mike-rankin/ESP32_eZ_Display_2/Images/LCD.jpg

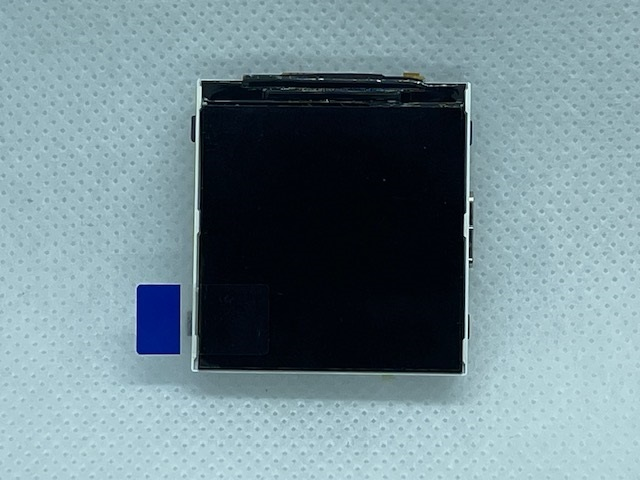
Images/LCD.jpg
