mike-rankin/ESP32_eZ_Display_2/Images/IMG_1215.jpg

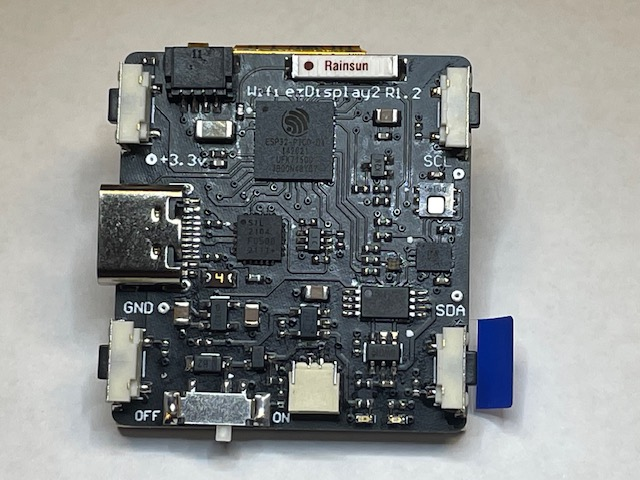
Images/IMG_1215.jpg
