mike-rankin/ESP32_eZ_Display_2/Images/display.jpg

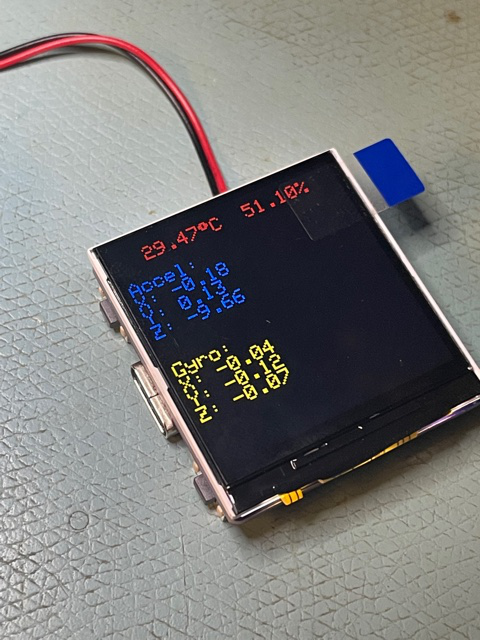
Images/display.jpg
