mike-rankin/ESP32_eZ_Display_2/PCB/BOM_Rev1.2.xlsx

Designator | Quantity | Vendor | Description | Manufacturer | Value | LCSC_Part_Number | Man_Part_Number
A1 | 1 | LCSC | Antenna Chip 2.4Gig | Rainsun | Chip Antenna | C99665 | AN9520-245
C1, C4, C6, C10, C12 | 5 | LCSC | CAP 0.1uF 0402 | CCTC | 0.1uF | C344190 | TCC0402X5R104M160AT
C2 | 1 | LCSC | CAP 1.5pF 0402 | Dafron | 1.5pF | C147344 | C1005NP0159CGTS
C3 | 1 | LCSC | CAP 1uF 16V 0402 | Walsin | 1uF | C83063 | 0402X105K160CT
C5 | 1 | LCSC | CAP 100uF 6.3V 1206 | Taiyo Yuden | 100uF | C87164 | JMK316BJ107ML-T
C7, C8, C9, C11 | 4 | LCSC | CAP 10uF 0805 | Samsung | 10uF | C307520 | CL21A106KOQNNNG
D1 | 1 | LCSC | DIODE SCHOTTKY 20V 500MA SOD123 | CJ | MBR0520 | C475717 | MBR0520
D2 | 1 | LCSC | LED Green 0402 | Lite-On | Green Led | C74338 | 16-213/GHC-YR1S1/3T
D3 | 1 | LCSC | LED RED 0402 | Lite-On | Red Led | C364556 | LTST-C281KRKT
D4 | 1 | LCSC | LED,RGB LED,SMD,RoHS | Foshan | RGB Led | C158099 | FC-B1010RGBT-HG
F1 | 1 | LCSC | PTC FUSE 500mA hold, 1A trip 0805 SMD | TLC | TLC-PSMD050 | C261942 | TLC-PSMD050
H1 | 1 | LCSC | CONN HEADER 4POS .100 R/A QWIIC | JST | QWiiC | C160404 | SM04B-SRSS-TB(LF)(SN)
J1 | 1 | LCSC | CONN RECPT USB-C | KHE | USB-C | C165948 | TYPE-C-31-M-12
J2 | 1 | LCSC | MIcro CONN 2POS 1.0MM SMT R/A | JUSHUO | Batt Con | C395299 | AFC10-S02QCC-00
Q1 | 1 | LCSC | TRANS 2NPN 44V 0.1A SC-70-6 | Changjiang | BC847S | C148112 | BC847S
Q2 | 1 | LCSC | MOSFET P-CH 20V 1.4A SC-70 | LRC | P-CH Mosfet | C172434 | LP1480WT1G
Q3 | 1 | LCSC | TRANSISTOR NPN GP 40V SC-70 | Changjiang | MMST3904 | C54879 | MMST3904
Q4 | 1 | LCSC | MOSFET 2N-CH 20V 6A TSSOP-8L | Fortune | FS8205A | C16052 | FS8205A
R1, R2, R3, R6, R7, R8, R9, R13, R14, R17 | 10 | LCSC | RES 10K 0402 | Guangdong | 10K | C258091 | RC-02W1002FT
R4, R5, R20, R21 | 4 | LCSC | RES 4.7K 0402 | Uni-Royal | 4.7K | C25900 | 0402WGF4701TCE
R10, R11 | 2 | LCSC | RES 5.1K 0402 | TyoHM | 5.1K | C325521 | RMC04025.1K1%N
R12 | 1 | LCSC | RES 22R 0402 | Uniroyal | 22R | C25092 | 0402WGF220JTCE
R15, R22, R23, R24, R25 | 5 | LCSC | RES 1K 0402 | Yageo | 1K | C106235 | RC0402FR-071KL
R16, R26, R27 | 3 | LCSC | RES 100K 0402 | Uniroyal Elec | 100K | C25741 | 0402WGF1003TCE
R18 | 1 | LCSC | RES 22K 0402 | LIZ Elec | 22K | C100310 | CR0402FF2202G
R19 | 1 | LCSC | RES 100R 0402 | Yageo | 100R | C106232 | RC0402FR-07100RL
S1, S2, S4, S5 | 4 | LCSC | Side Actuated Button R/A | HYP | Button R/A | C319377 | 1TS002G-2300-3500-CT
S3 | 1 | LCSC | SWITCH SLIDE SMD | Korean Hroparts Elec | SWITCH SLIDE | C128955 | K3-1296S-E1
U1 | 1 | LCSC | RF Transceiver ICs QFN-48_7x7x05P RoHS | Espressif | ESP32-PICO-D4 | C193707 | ESP32-PICO-D4
U2 | 1 | LCSC | IC BRIDGE USB TO UART 24QFN | Silicon Labs | CP2104N | C47742 | CP2104-F03-GMR
U3 | 1 | LCSC | IMU ACCEL/GYRO I2C/SPI 14VFLGA | ST MICRO | LSM6DS3TR | C95230 | LSM6DS3TR
U4 | 1 | LCSC | Humidity/Temperature Sensor | Texas Instruments | HDC1080DMBT | C82227 | HDC1080DMBR
U5 | 1 | LCSC | IC LDO 3.3V 0.5A SOT23-5 | Holtek | HT7833 | C164106 | HT7833
U6 | 1 | LCSC | Charger IC Lithium-Ion/Polymer SOT23-5 | Microchip | MCP73831T-2ACI | C424093 | MCP73831T-2ACI/OT
U7 | 1 | LCSC | IC LITHIUM BATT PROTECT SOT-23-6L | PUOLOP | DW01A | C351410 | DW01A
X1 | 1 | BuyDisplay | 1.54 INCH TFT GLASS COLOR | BuyDisplay | TFT_1.54" |  | ER-TFT1.54-1
