mike-rankin/ESP32_eZ_Display_2/PCB/Parts_Placement_Rev1.2.pdf

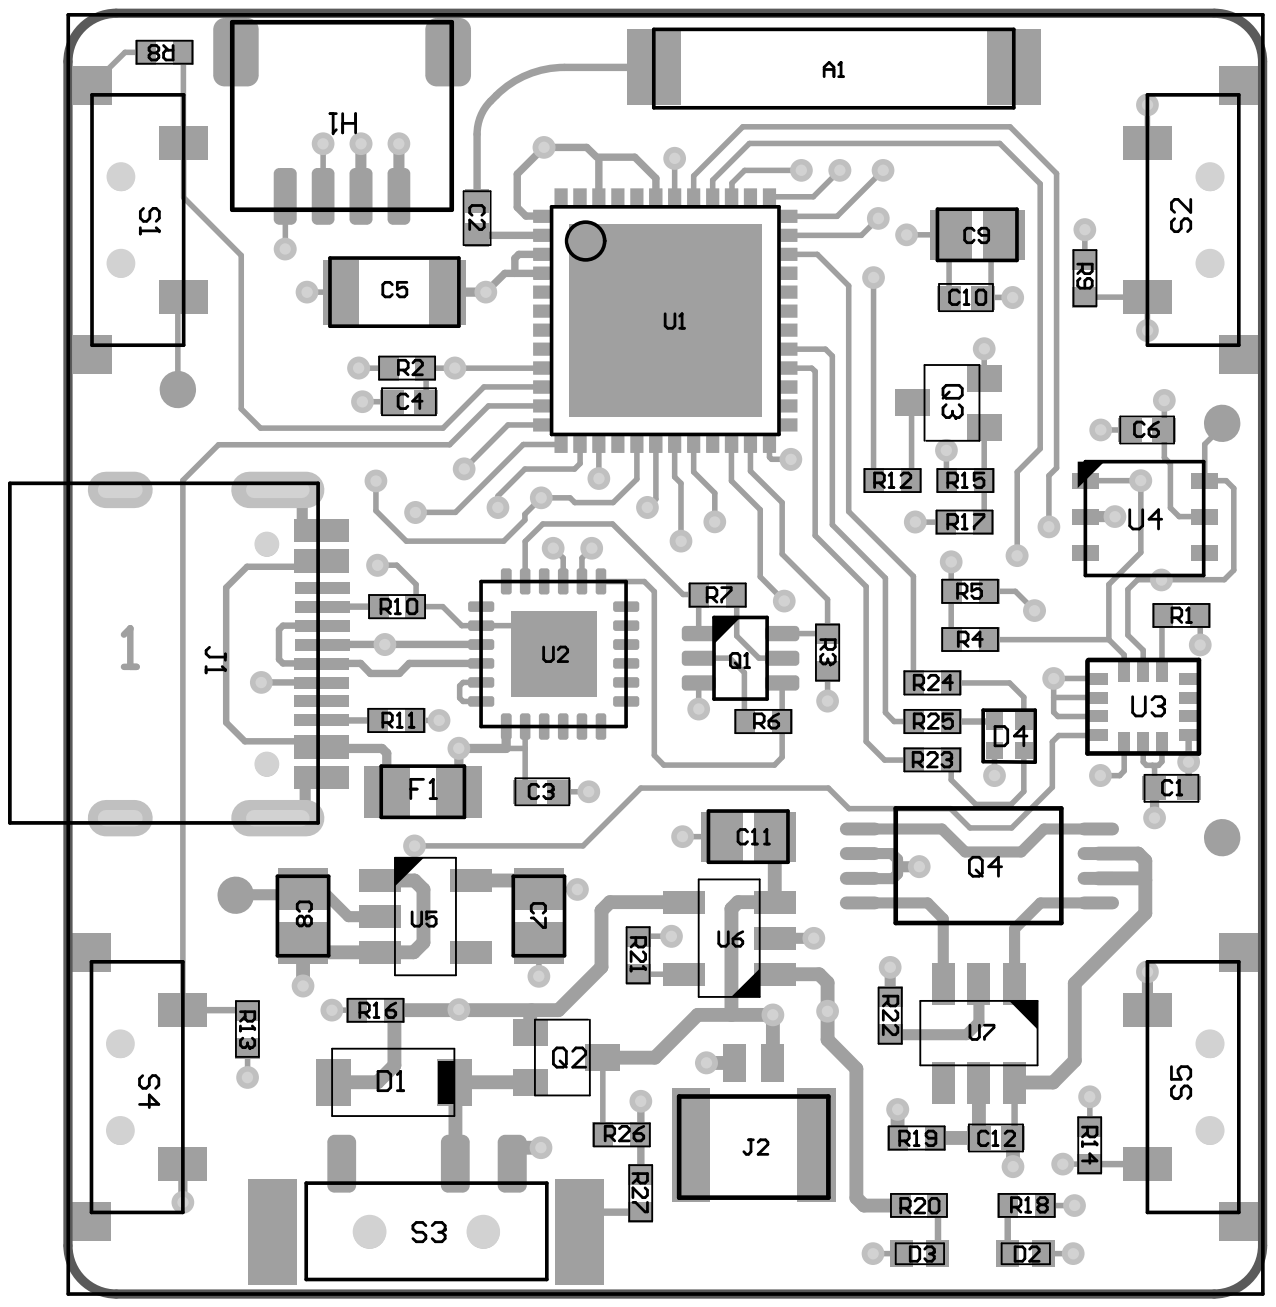
[picture p4: page 1]
