mike-rankin/ESP32_eZ_Display_2/PCB/Schematic_Rev1.2.pdf

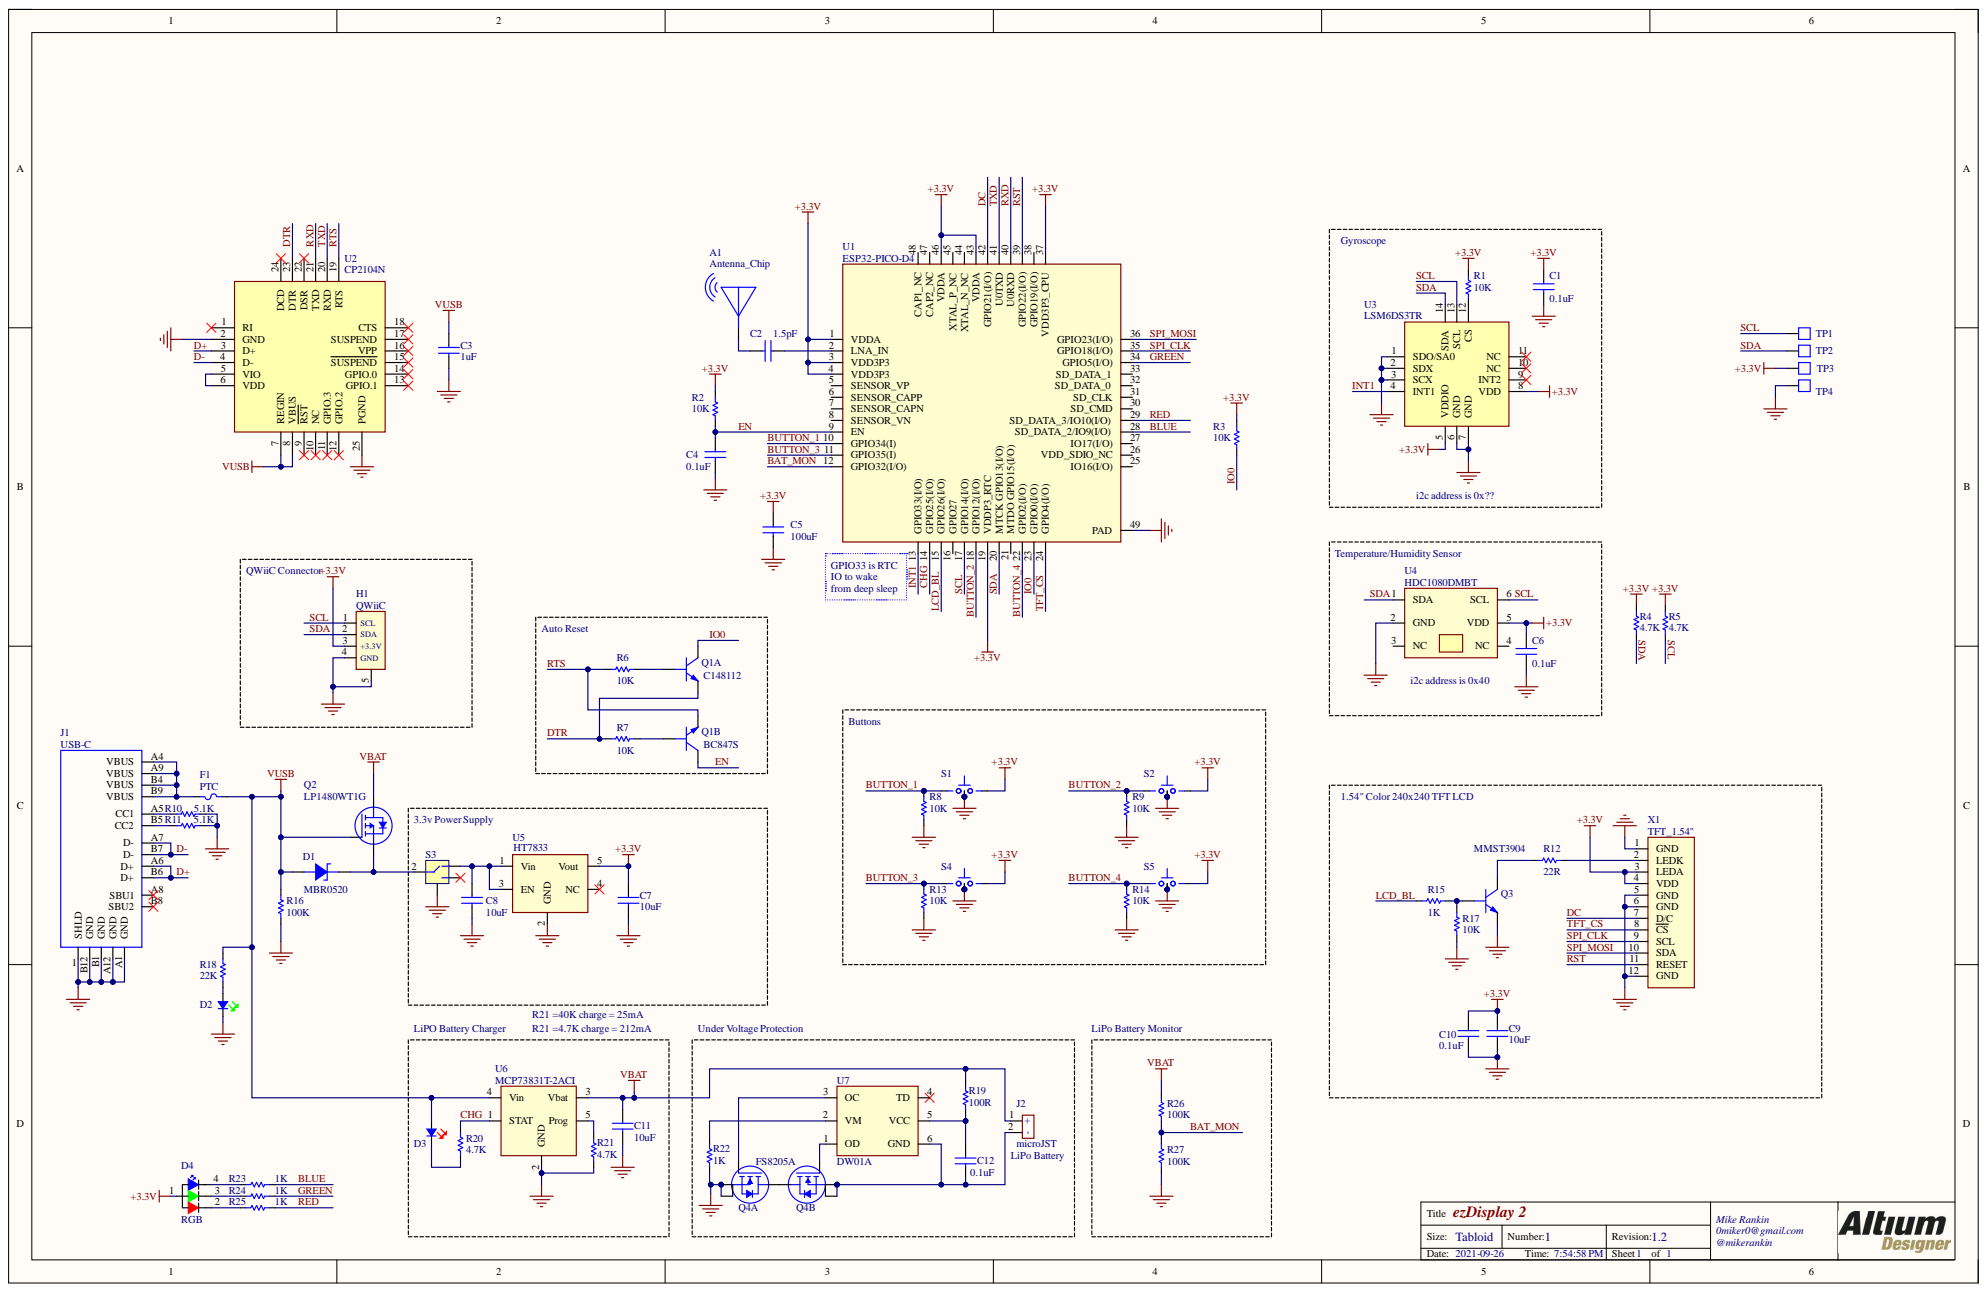
[picture p5: page 1]

RTS 19 RXD 20 TXD 21 DSR 22 DTR 23

A9 4 VBUS

CHG 1 | 5 | 2 | 5
