mike-rankin/ESP32_eZ_Display_2/(commit log)

2021-08-24 updated files
    [BOM_Rev1.1.xlsx, Pick Place for PCB_Rev1.1_Imperial.csv, Pick Place for PCB_Rev1.1_Metric.csv]
2021-08-24 updated bom
    [BOM_Rev1.1.xlsx]
2021-09-27 Replaced old revision with new
    [BOM_Rev1.1.xlsx, BOM_Rev1.2.xlsx, Imperial_Pick Place for PCB_Rev1.2.csv, Metric_Pick Place for PCB_Rev1.2.csv, Pick Place for PCB_Rev1.1_Imperial.csv, Pick Place for PCB_Rev1.1_Metric.csv]
